tpII/2026-g1-clickaula/README.md

# 2026-g1-clickaula
Taller de Proyecto II 2026 — Grupo G1 — ClickAula
