tpII/2026-g1-clickaula/Disenio Caja Pulsadores y RBPi/Caja_Base_v2.stl

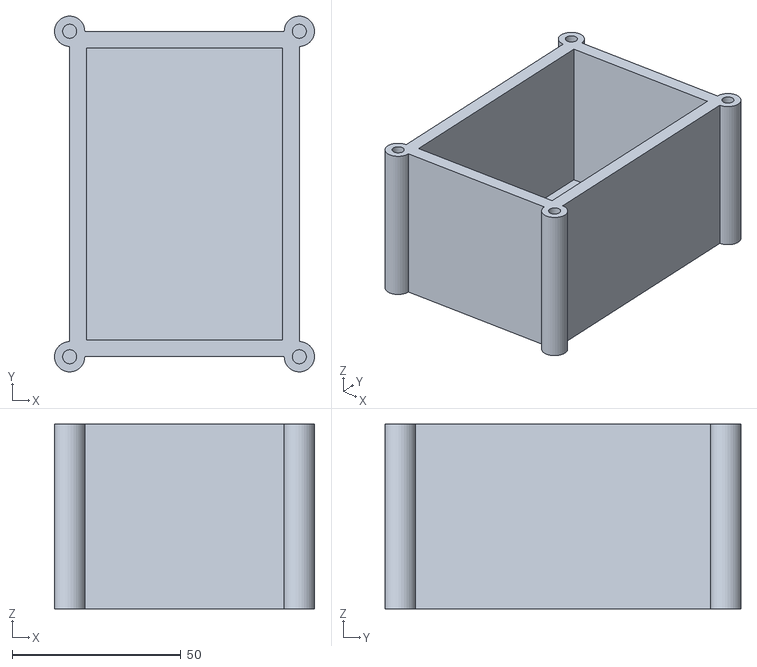
[picture p9: CAD file, 2026-10-30]
Disenio Caja Pulsadores y RBPi/Caja_Base_v2.stl
77.1 x 105.5 x 54.7
