tpII/2026-g1-clickaula/Disenio Caja Pulsadores y RBPi/Tapa.stl

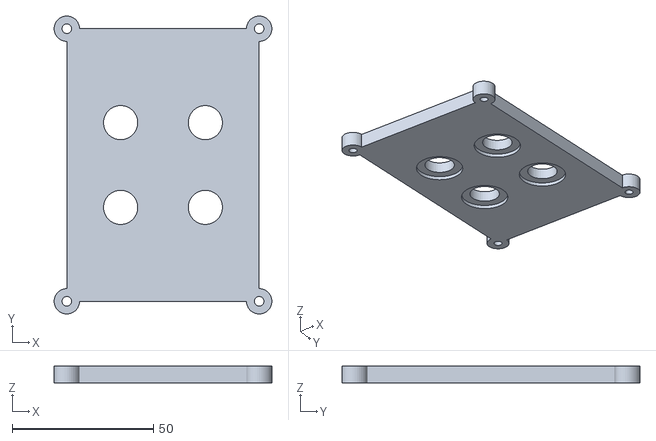
[picture p10: CAD file, 2026-10-30]
Disenio Caja Pulsadores y RBPi/Tapa.stl
77.1 x 105.5 x 6.00
