tpII/2026-g1-clickaula/Disenio Caja Pulsadores y RBPi/Caja_Base.stl

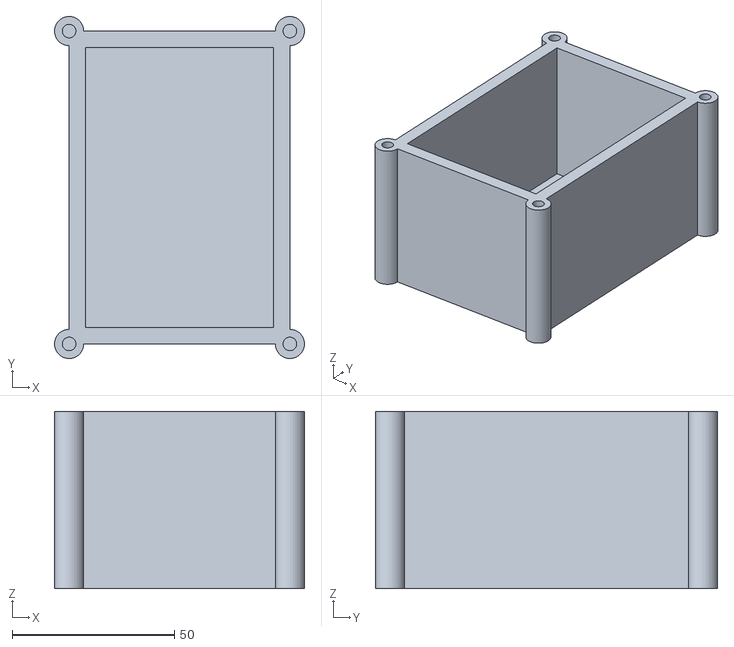
[picture p11: CAD file, 2026-10-30]
Disenio Caja Pulsadores y RBPi/Caja_Base.stl
77.1 x 105.5 x 54.7
