tpII/2026-g1-clickaula/(list of files, cad)

Other CAD files:
Disenio Caja Pulsadores y RBPi/TP2 Caja.f3d
