tpII/2026-g1-clickaula/firmware/pulsador/secretos.ejemplo.h

// Copiá este archivo como secretos.h y completalo. secretos.h no se sube al
// repositorio. Tienen que ser los mismos datos que se cargaron en la Pi con
// raspberry/instalar.sh.

#pragma once

#define WIFI_SSID  "ClickAula"
#define WIFI_CLAVE "cambiar-esta-clave"
