tpII/2026-g1-clickaula/(commit log)

2026-10-10 cambios en la bitacora
2026-10-14 Modificacion de resposables de tareas
2026-10-22 Firmware y Raspberry PI; Entradas en la BITACORA
2026-10-30 Caja de pulsadores y broker
